islamahmoud97-cpu/Konstruktionsprojekt-/(list of files, cad)

Other CAD files:
OldVersion/60199320_1_20_20.ipt
OldVersion/60199320_2_20.ipt
OldVersion/60199320_3_20.ipt
OldVersion/60199320_4.ipt
OldVersion/Assembly1.iam
OldVersion/Ausgleichskupplung.iam
OldVersion/Compress Spring11.ipt
OldVersion/DIN 59370 - 30 x 3 - 0,001.ipt
OldVersion/DIN1026-1 - U 400 - 1500.ipt
OldVersion/Deckel.ipt
OldVersion/Deckelscheibe.ipt
OldVersion/EN ISO 1127(2) - 10 x 1 - 0,001.ipt
OldVersion/Elektrischer Schalter.ipt
OldVersion/Elektromotor.ipt
OldVersion/Federführungswellen.ipt
OldVersion/Federwellen-Gleitlager.ipt
OldVersion/Festlagertopf.ipt
OldVersion/Führung.ipt
OldVersion/Führungsgleitlager.ipt
OldVersion/Gewindemutter.ipt
OldVersion/Grundplatte.ipt
OldVersion/Gummi platt unten.ipt
OldVersion/Hülle des Plattform-Oberteils.ipt
OldVersion/Hülle des Plattform-Unterteils.ipt
OldVersion/Loslagertopf.ipt
OldVersion/Plattform-Oberteil.ipt
OldVersion/Plattform-Unterteil.ipt
OldVersion/Rubber Kupplung.ipt
OldVersion/Schutzpuffer.ipt
OldVersion/Spindel.ipt
OldVersion/Verbindungsplatte.ipt
OldVersion/Verfahrschlitten.ipt
OldVersion/Wand.ipt
OldVersions/60199320_2_20.0001.ipt
OldVersions/60199320_3_20.0001.ipt
OldVersions/Assembly1.0032.iam
OldVersions/Ausgleichskupplung.0002.iam
OldVersions/Compress Spring11.0001.ipt
OldVersions/DIN 59370 - 30 x 3 - 0,001.0001.ipt
OldVersions/DIN1026-1 - U 400 - 1500.0001.ipt
OldVersions/Deckel oben.0003.ipt
OldVersions/Dekel oben Plattform.0002.ipt
OldVersions/Dekel unten Plattform.0001.ipt
OldVersions/Elektrische Knopf.0001.ipt
OldVersions/Elektromotor.0004.ipt
OldVersions/Federführungswellen.0005.ipt
OldVersions/Festlagertopf.0006.ipt
OldVersions/Festlagertopf.0007.ipt
OldVersions/Führung.0001.ipt
OldVersions/Gewinde Mutter Mitte.0001.ipt
OldVersions/Gewindemutter.0002.ipt
OldVersions/Gewindemutter.0003.ipt
OldVersions/Gleit lager führung.0001.ipt
OldVersions/Gleit lager führung.0002.ipt
OldVersions/Gleit überlast.0002.ipt
OldVersions/Grundgestell.0004.ipt
OldVersions/Grundplatte.0005.ipt
OldVersions/Grundplatte.0006.ipt
OldVersions/Gummi platt unten.0001.ipt
OldVersions/Loslagertopf.0005.ipt
OldVersions/Oben.0004.ipt
OldVersions/Oben.0005.ipt
OldVersions/Platt oben.0004.ipt
OldVersions/Platt unten.0004.ipt
OldVersions/Plattform-Oberteil.0006.ipt
OldVersions/Plattform-Unterteil.0006.ipt
OldVersions/Spindel.0010.ipt
OldVersions/Unten.0004.ipt
OldVersions/Verfahrschlitten.0006.ipt
OldVersions/Wand.0003.ipt
OldVersions/gummi Muttergewinde.0003.ipt
OldVersions/mitte.0005.ipt
OldVersions/saule.0004.ipt
OldVersions/Überlast Führung.0002.ipt
OldVersions/Überlast Führung.0003.ipt
