islamahmoud97-cpu/Konstruktionsprojekt-/12_SaadMahmoud Islam_Z.pdf

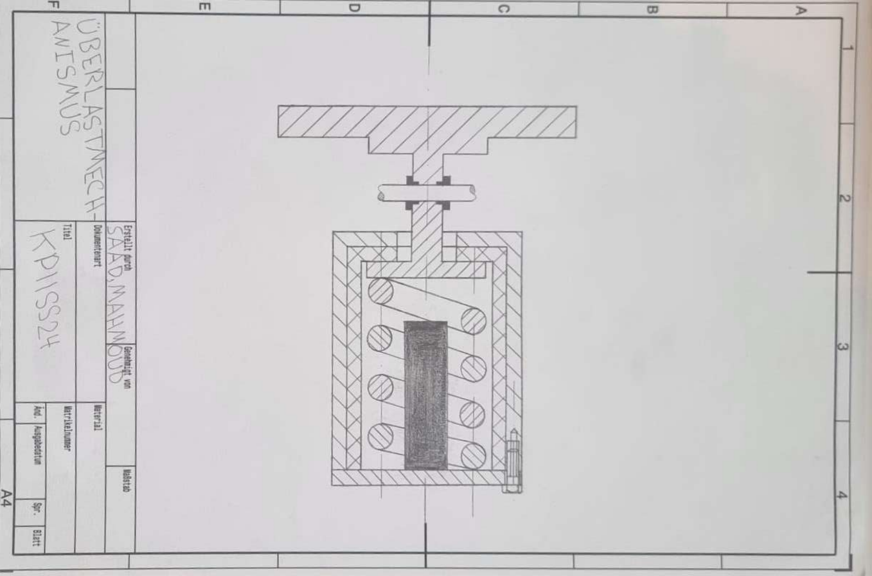
[picture p10: page 1]
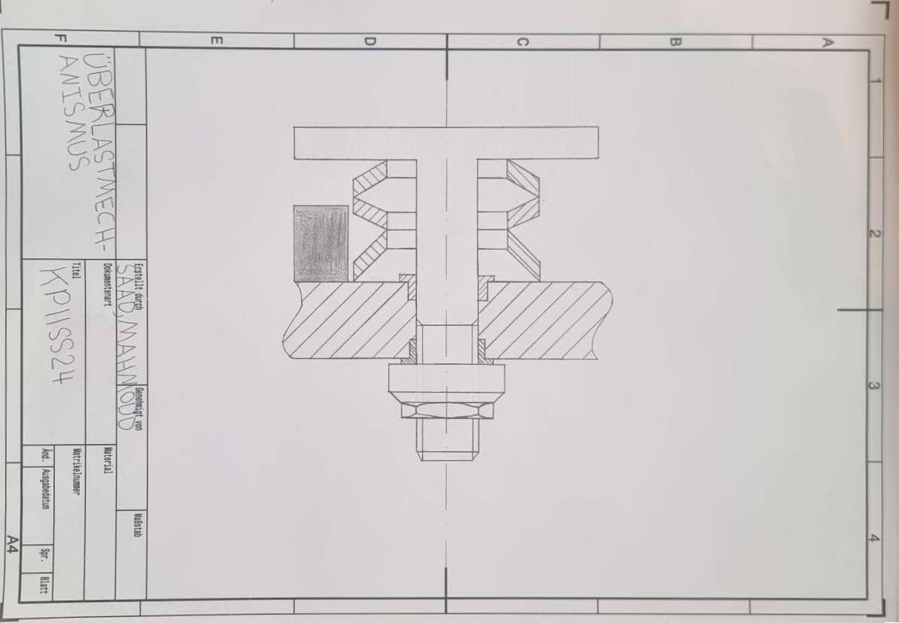
[picture p11: page 2]
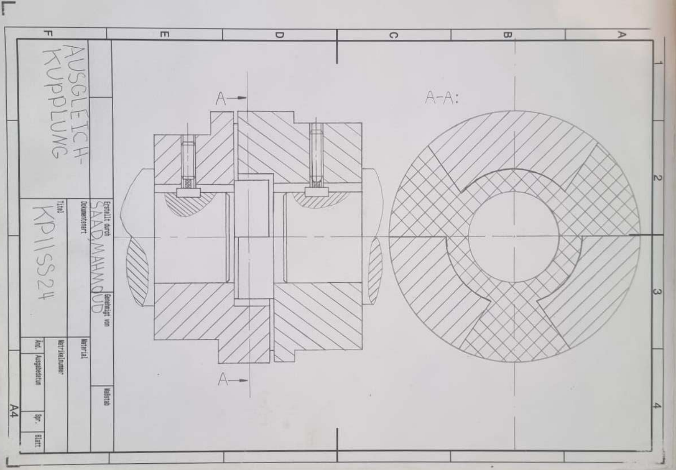
[picture p12: page 3]
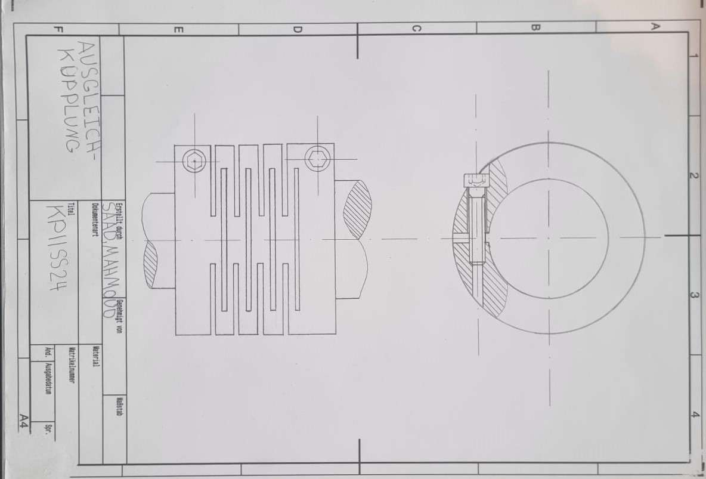
[picture p13: page 4]
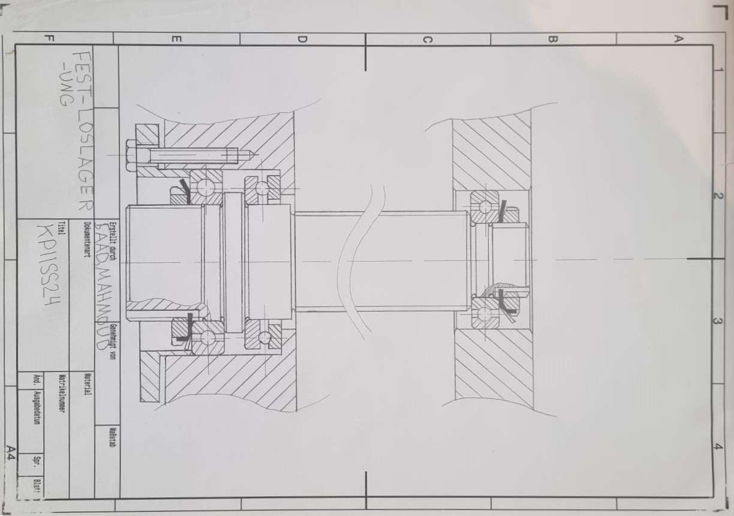
[picture p14: page 5]
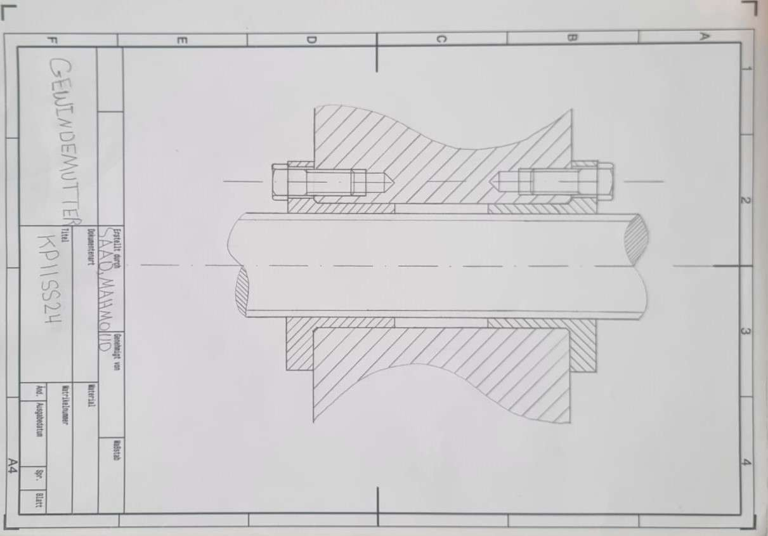
[picture p15: page 6]
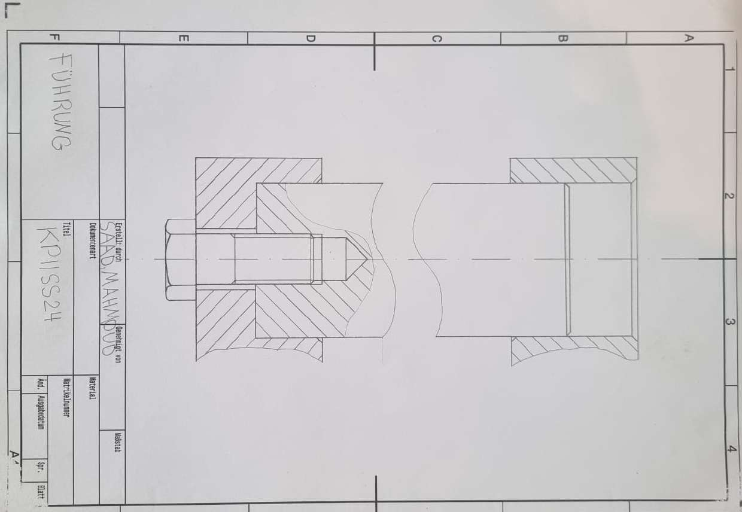
[picture p16: page 7]
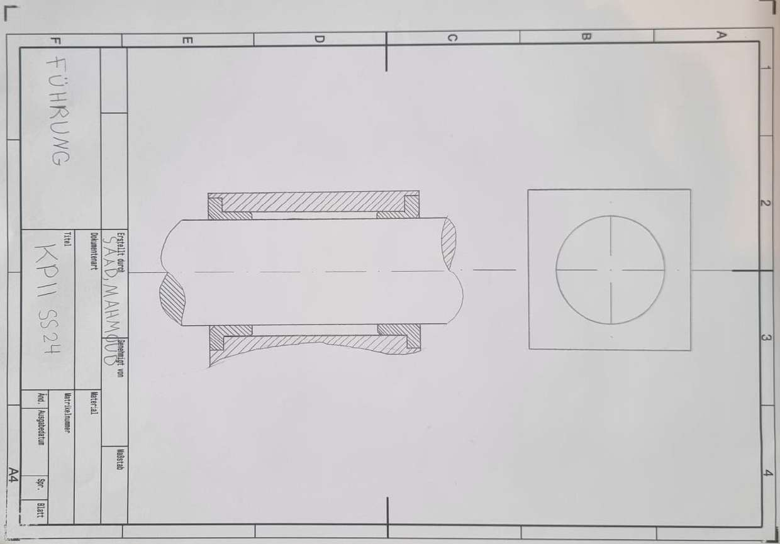
[picture p17: page 8]
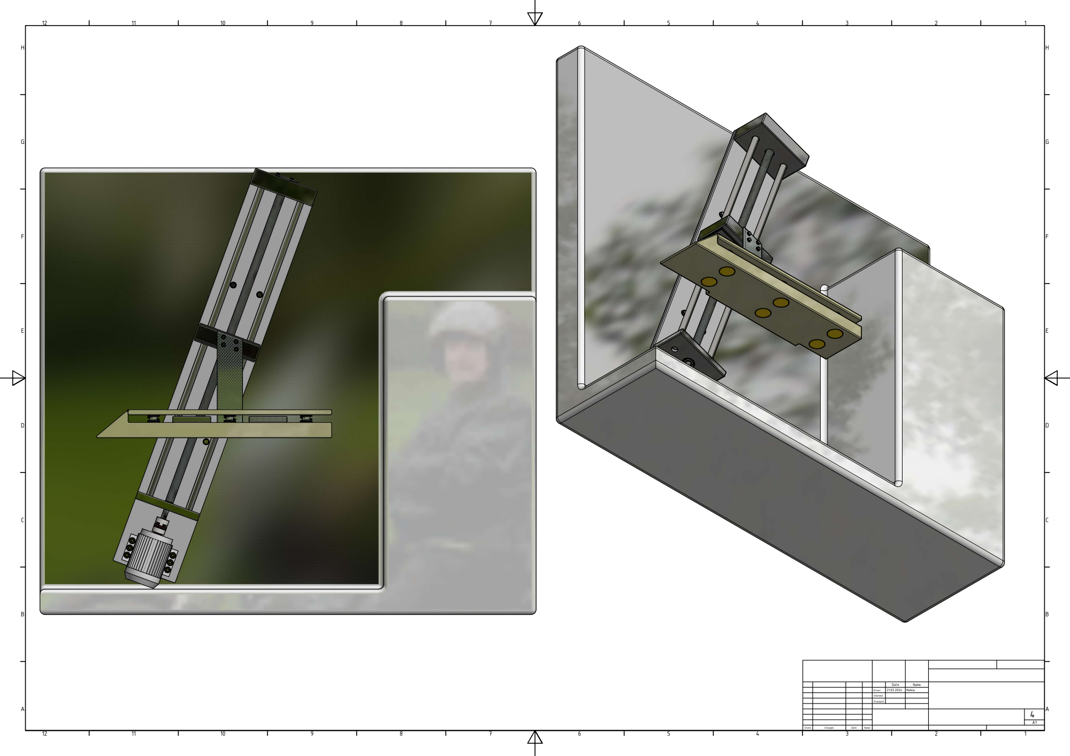
[picture p18: page 9]

D r a w n | 1.0 3.2 | N o kia

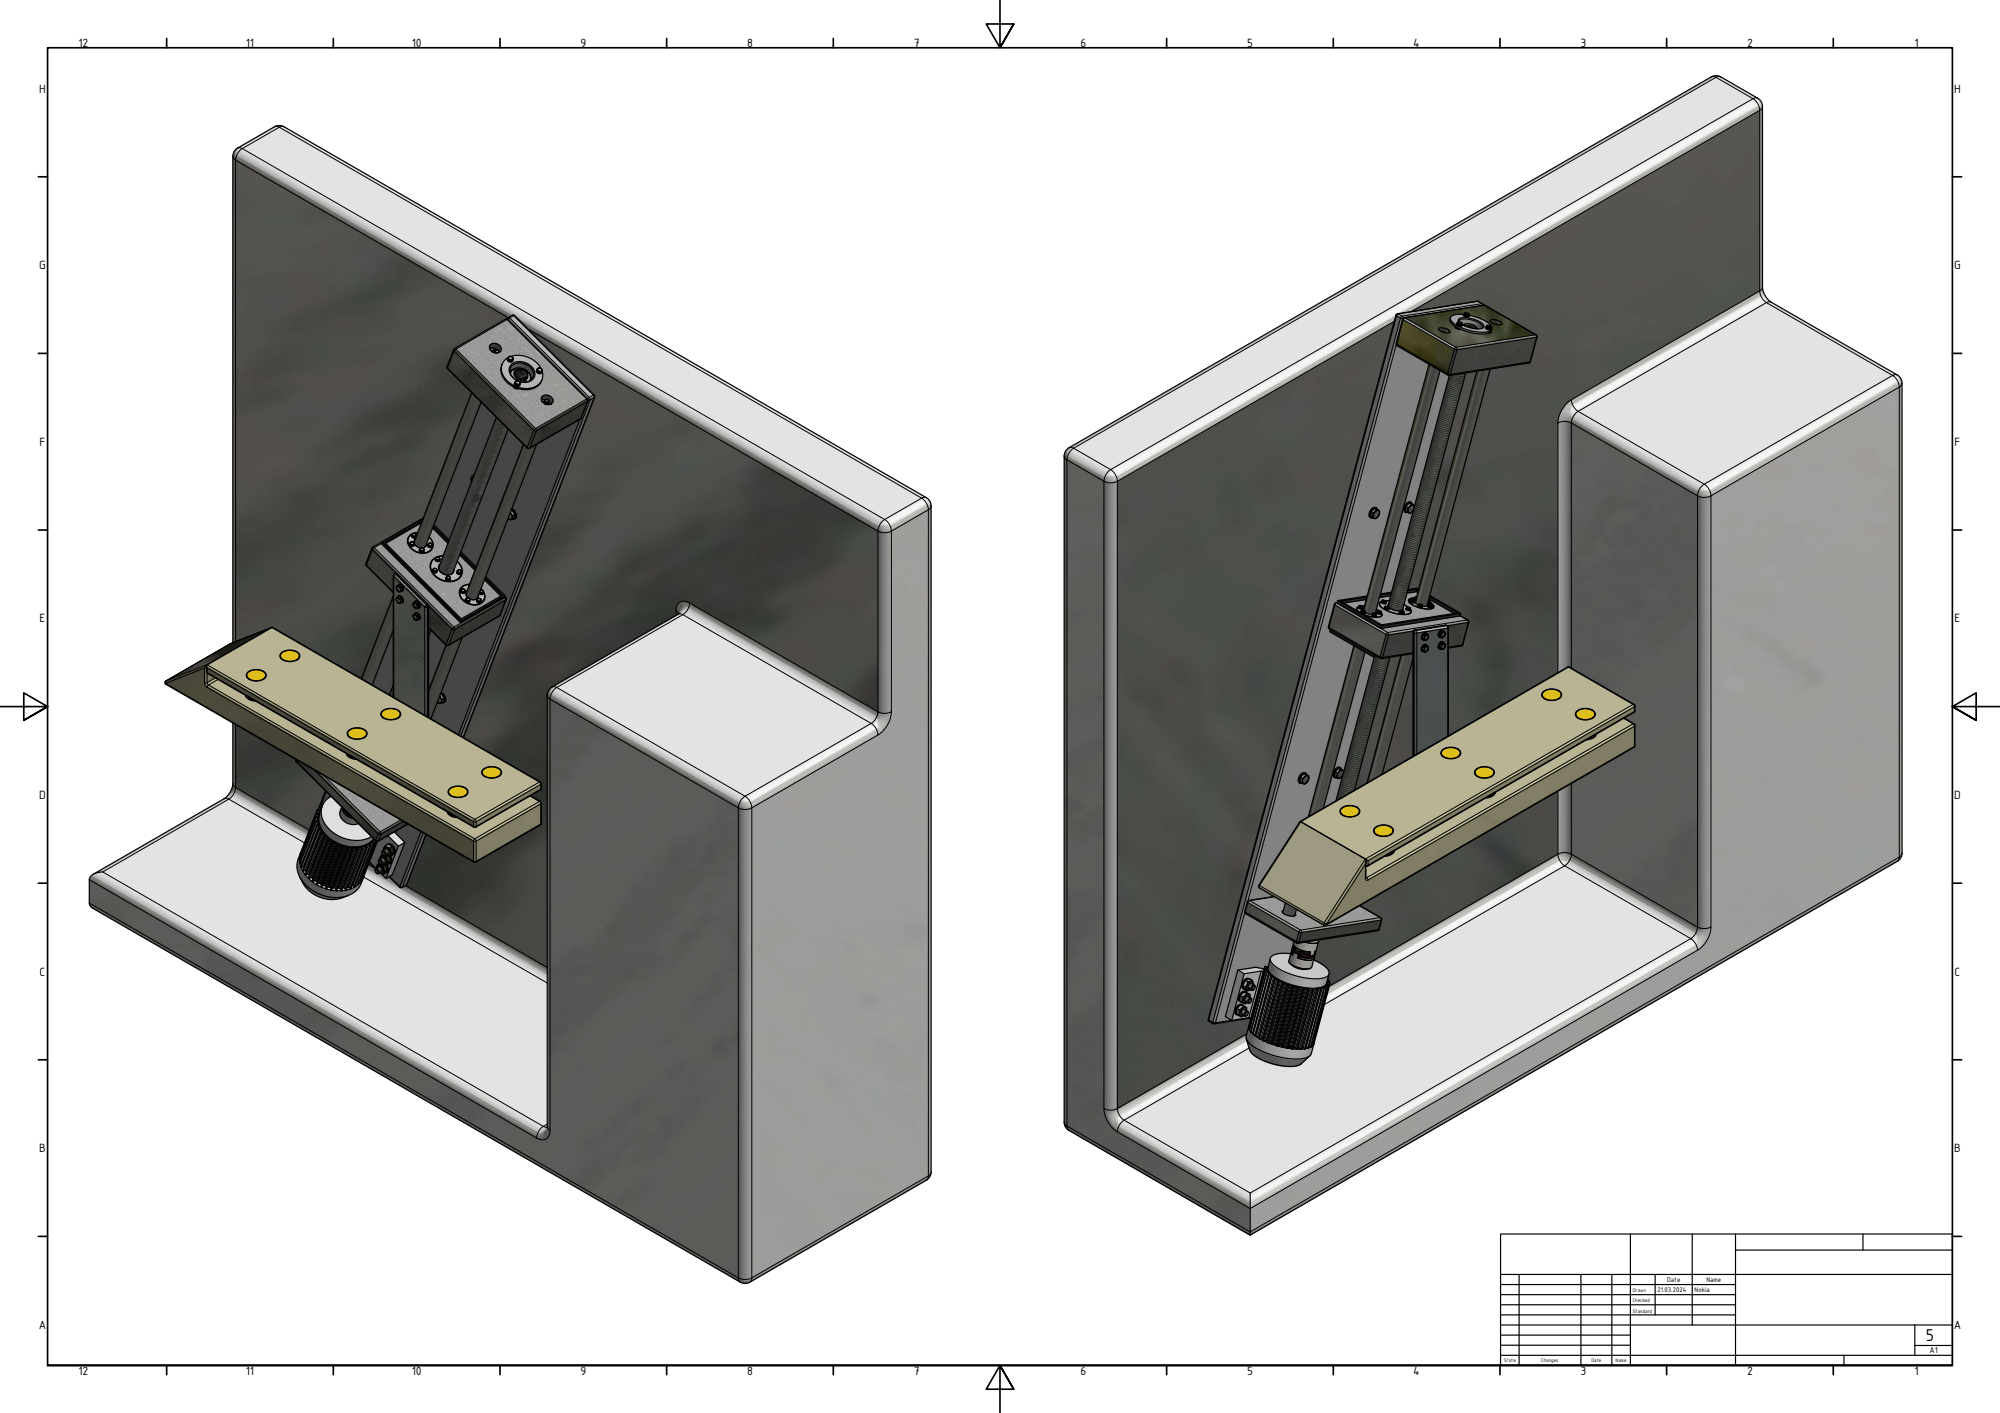
[picture p19: page 10]

D r a w n | 1.0 3.2 | N o kia

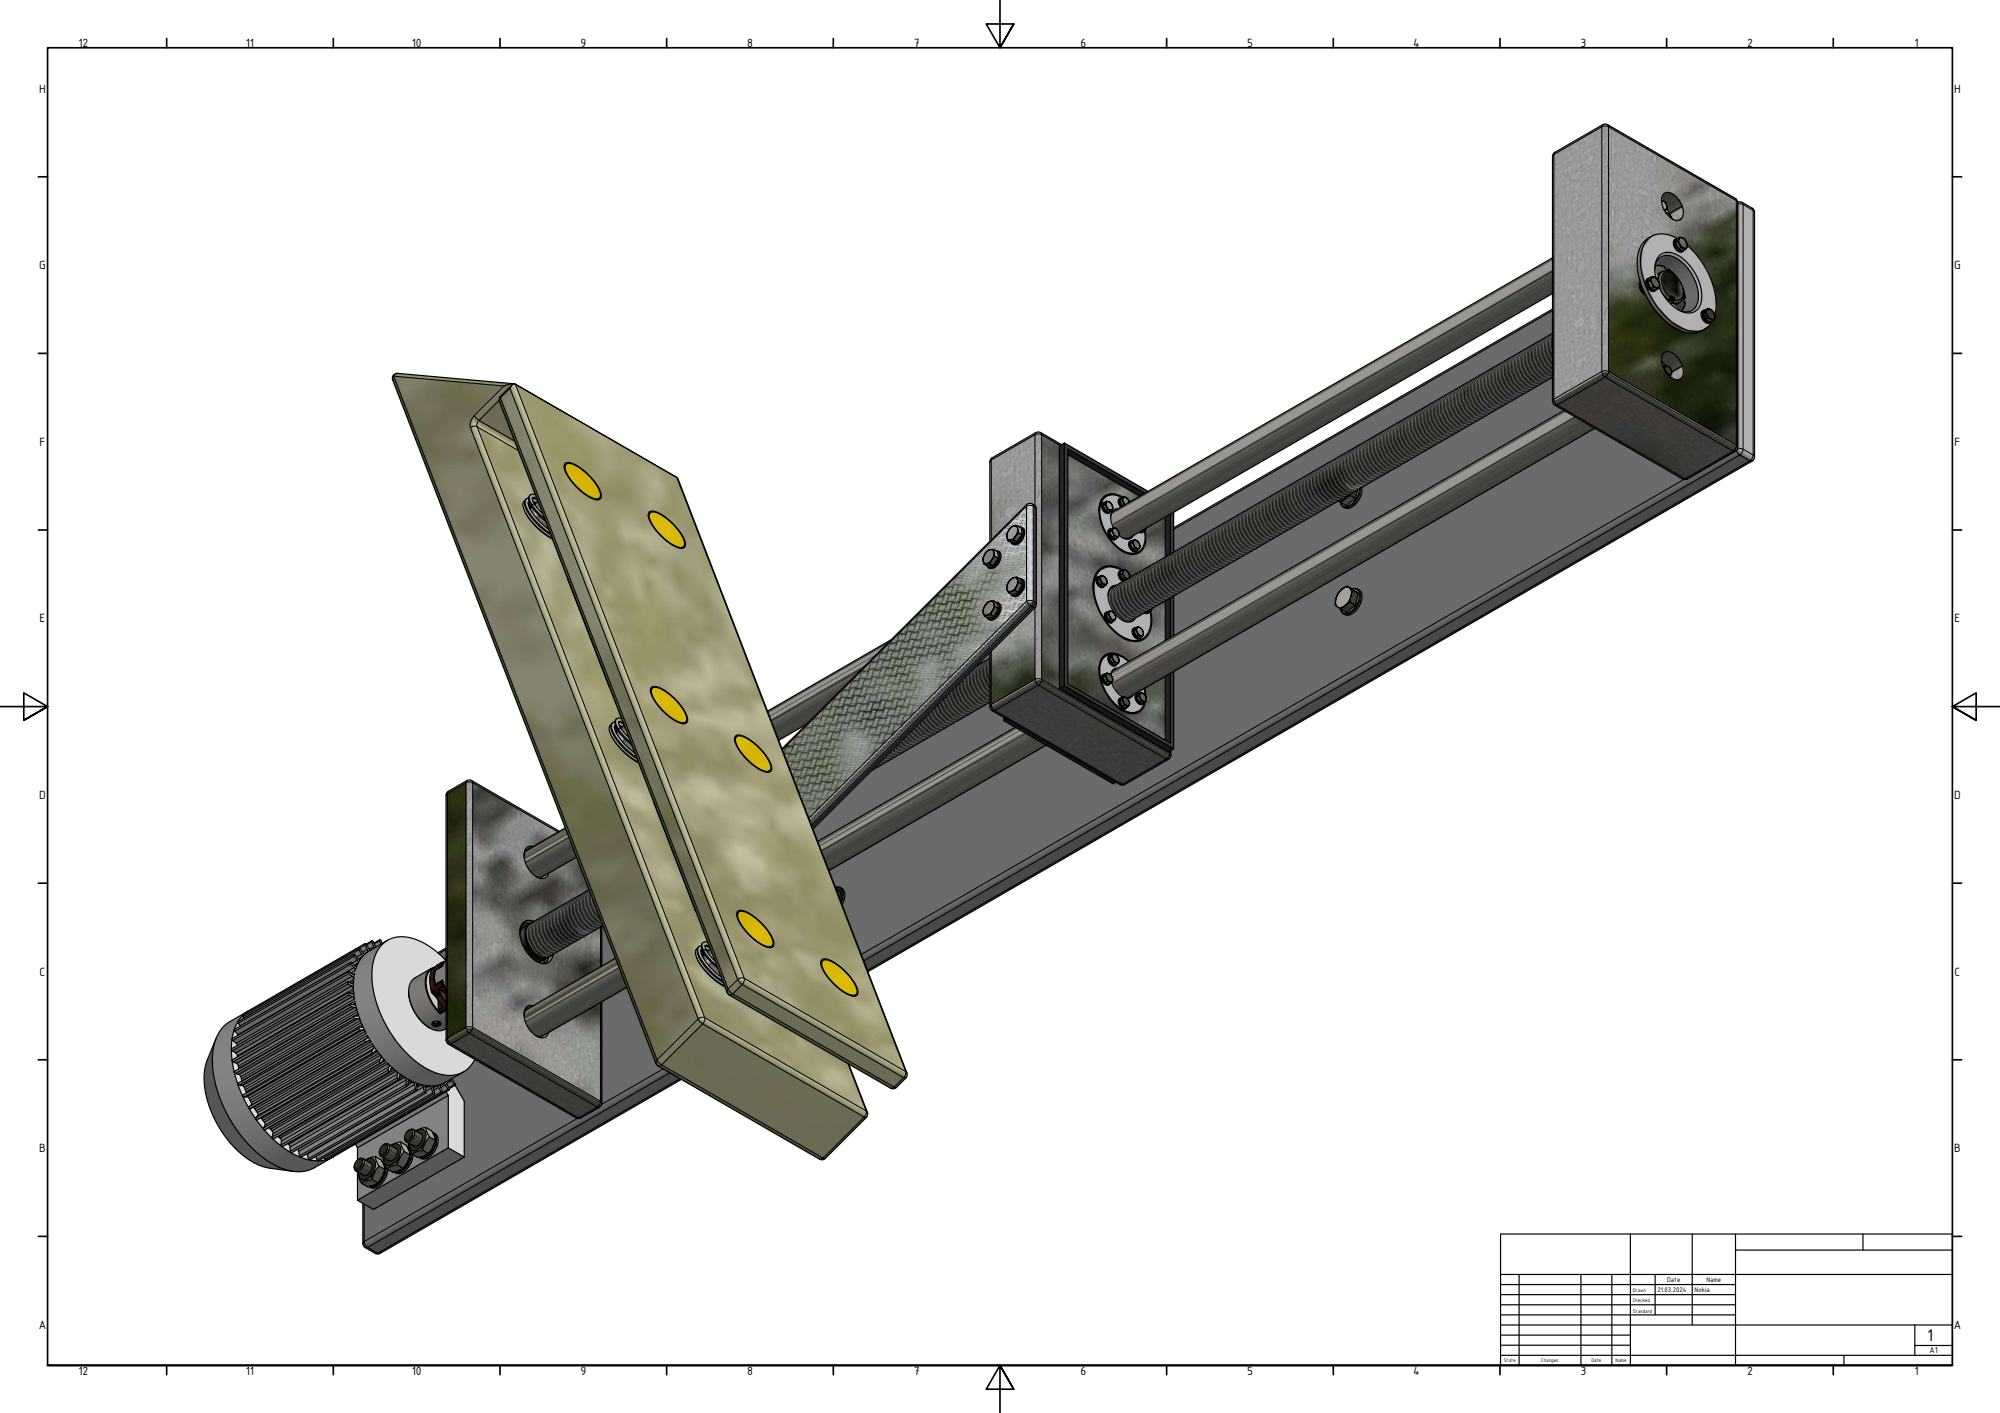
[picture p20: page 11]

D r a w n | 1.0 3.2 | N o kia

A ( 1 : 2,2 )

C | C

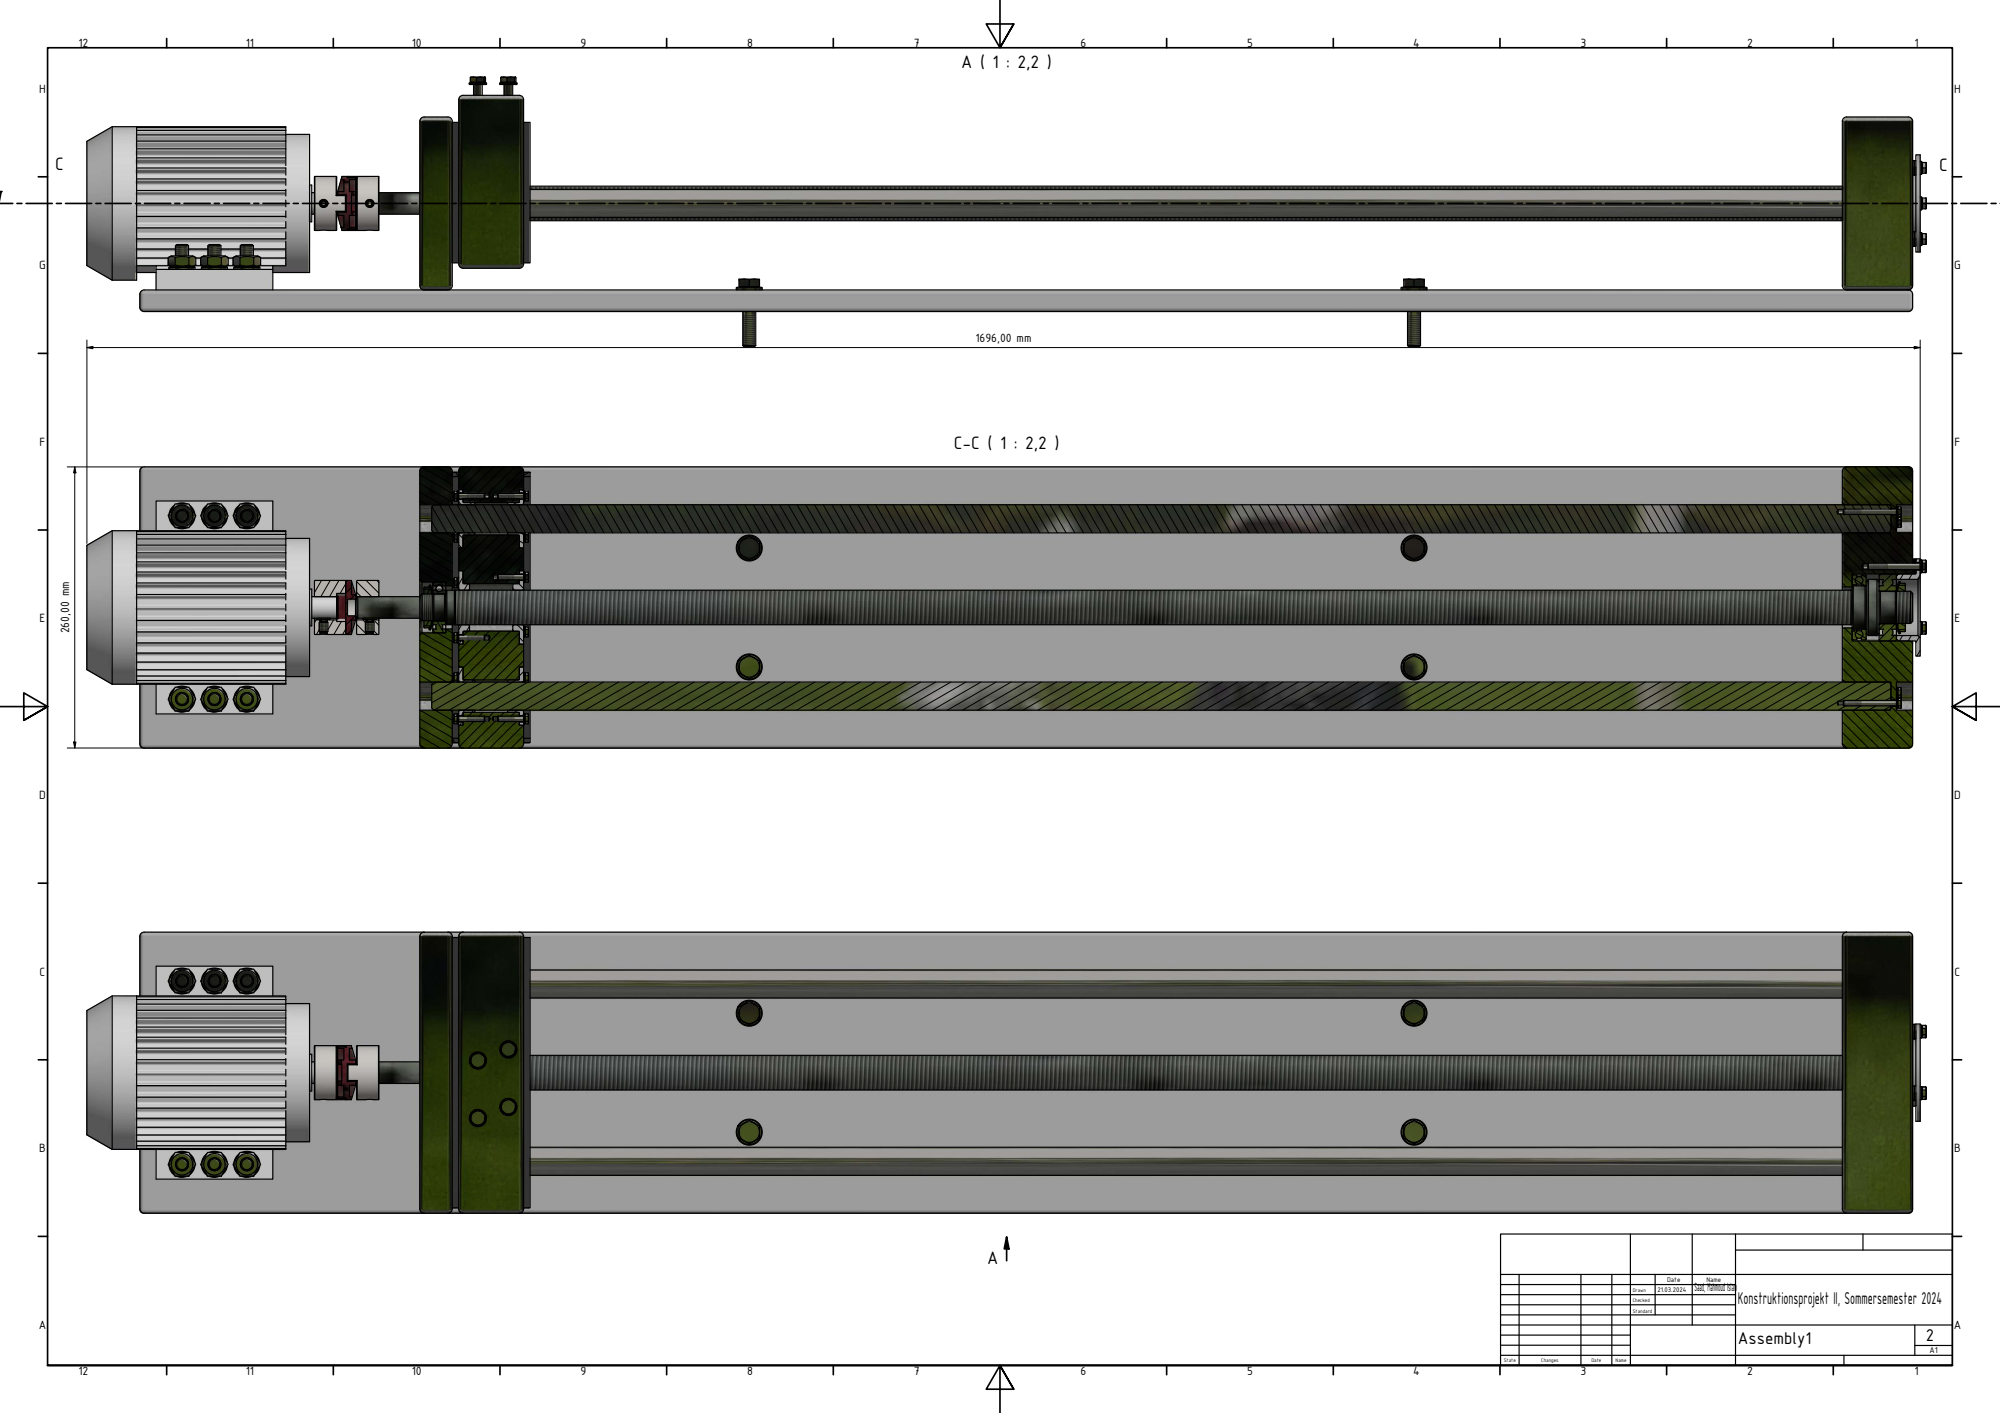
[picture p21: page 12]
Assembly1; State; Changes; Date; Name

Date | Name | Konstruktionsprojekt II, Sommersemester 2024

Drawn | 21.03.2024 | Saad, Mahmoud Islam

Checked

Standard

E ( 1 : 2 )

E

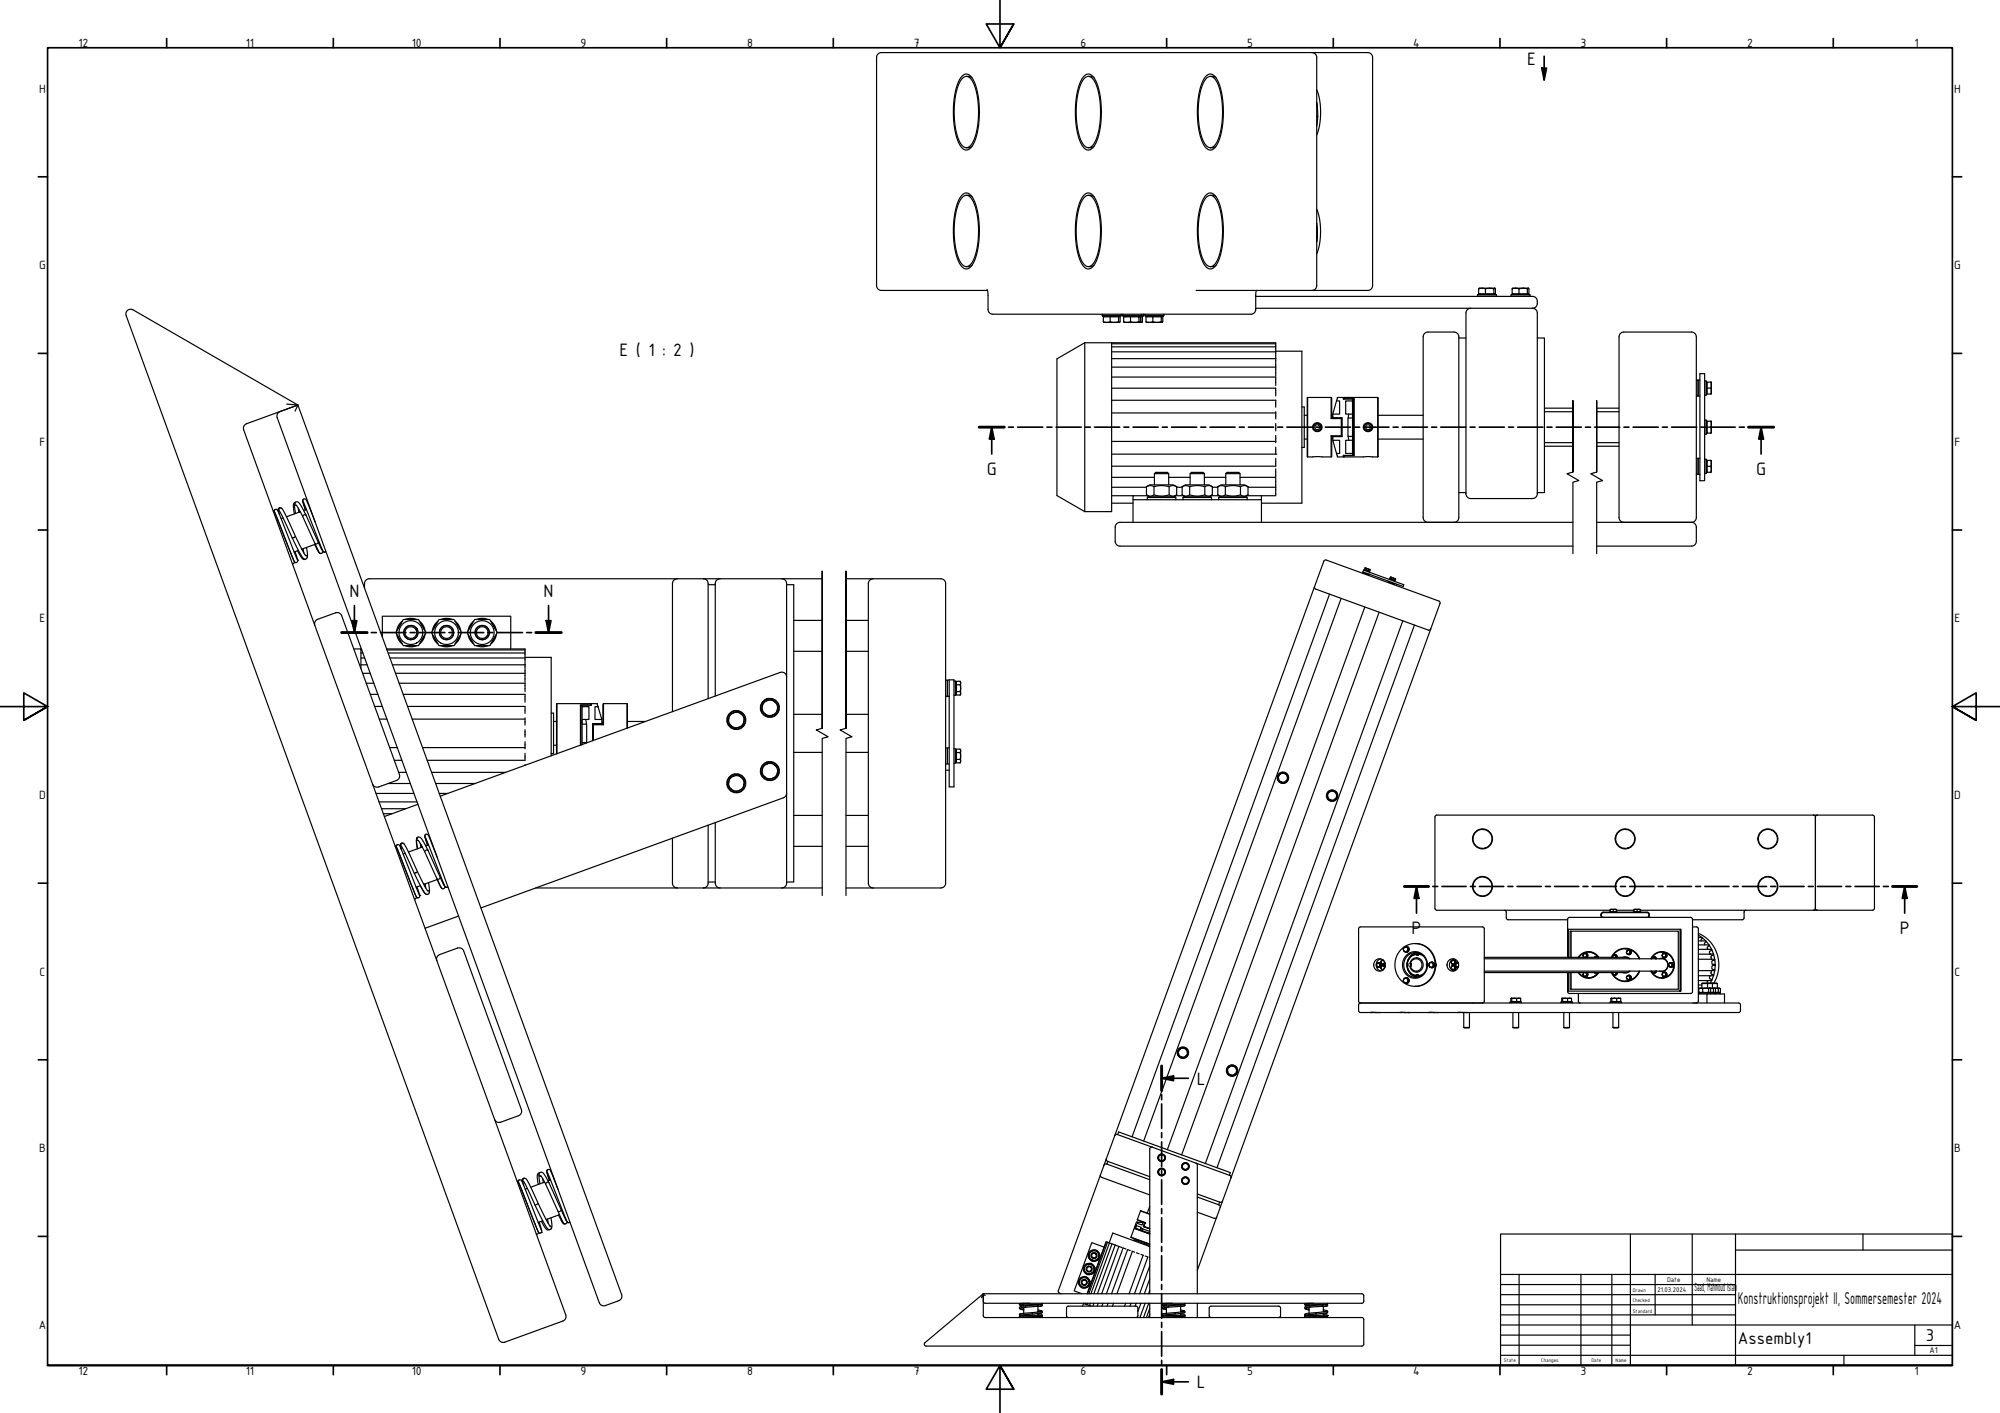
[picture p22: page 13]
Assembly1; State; Changes; Date; Name

Date | Name | Konstruktionsprojekt II, Sommersemester 2024

Drawn | 21.03.2024 | Saad, Mahmoud Islam

Checked

Standard

G-G ( 1 : 1 )

R-R ( 2 : 1 )

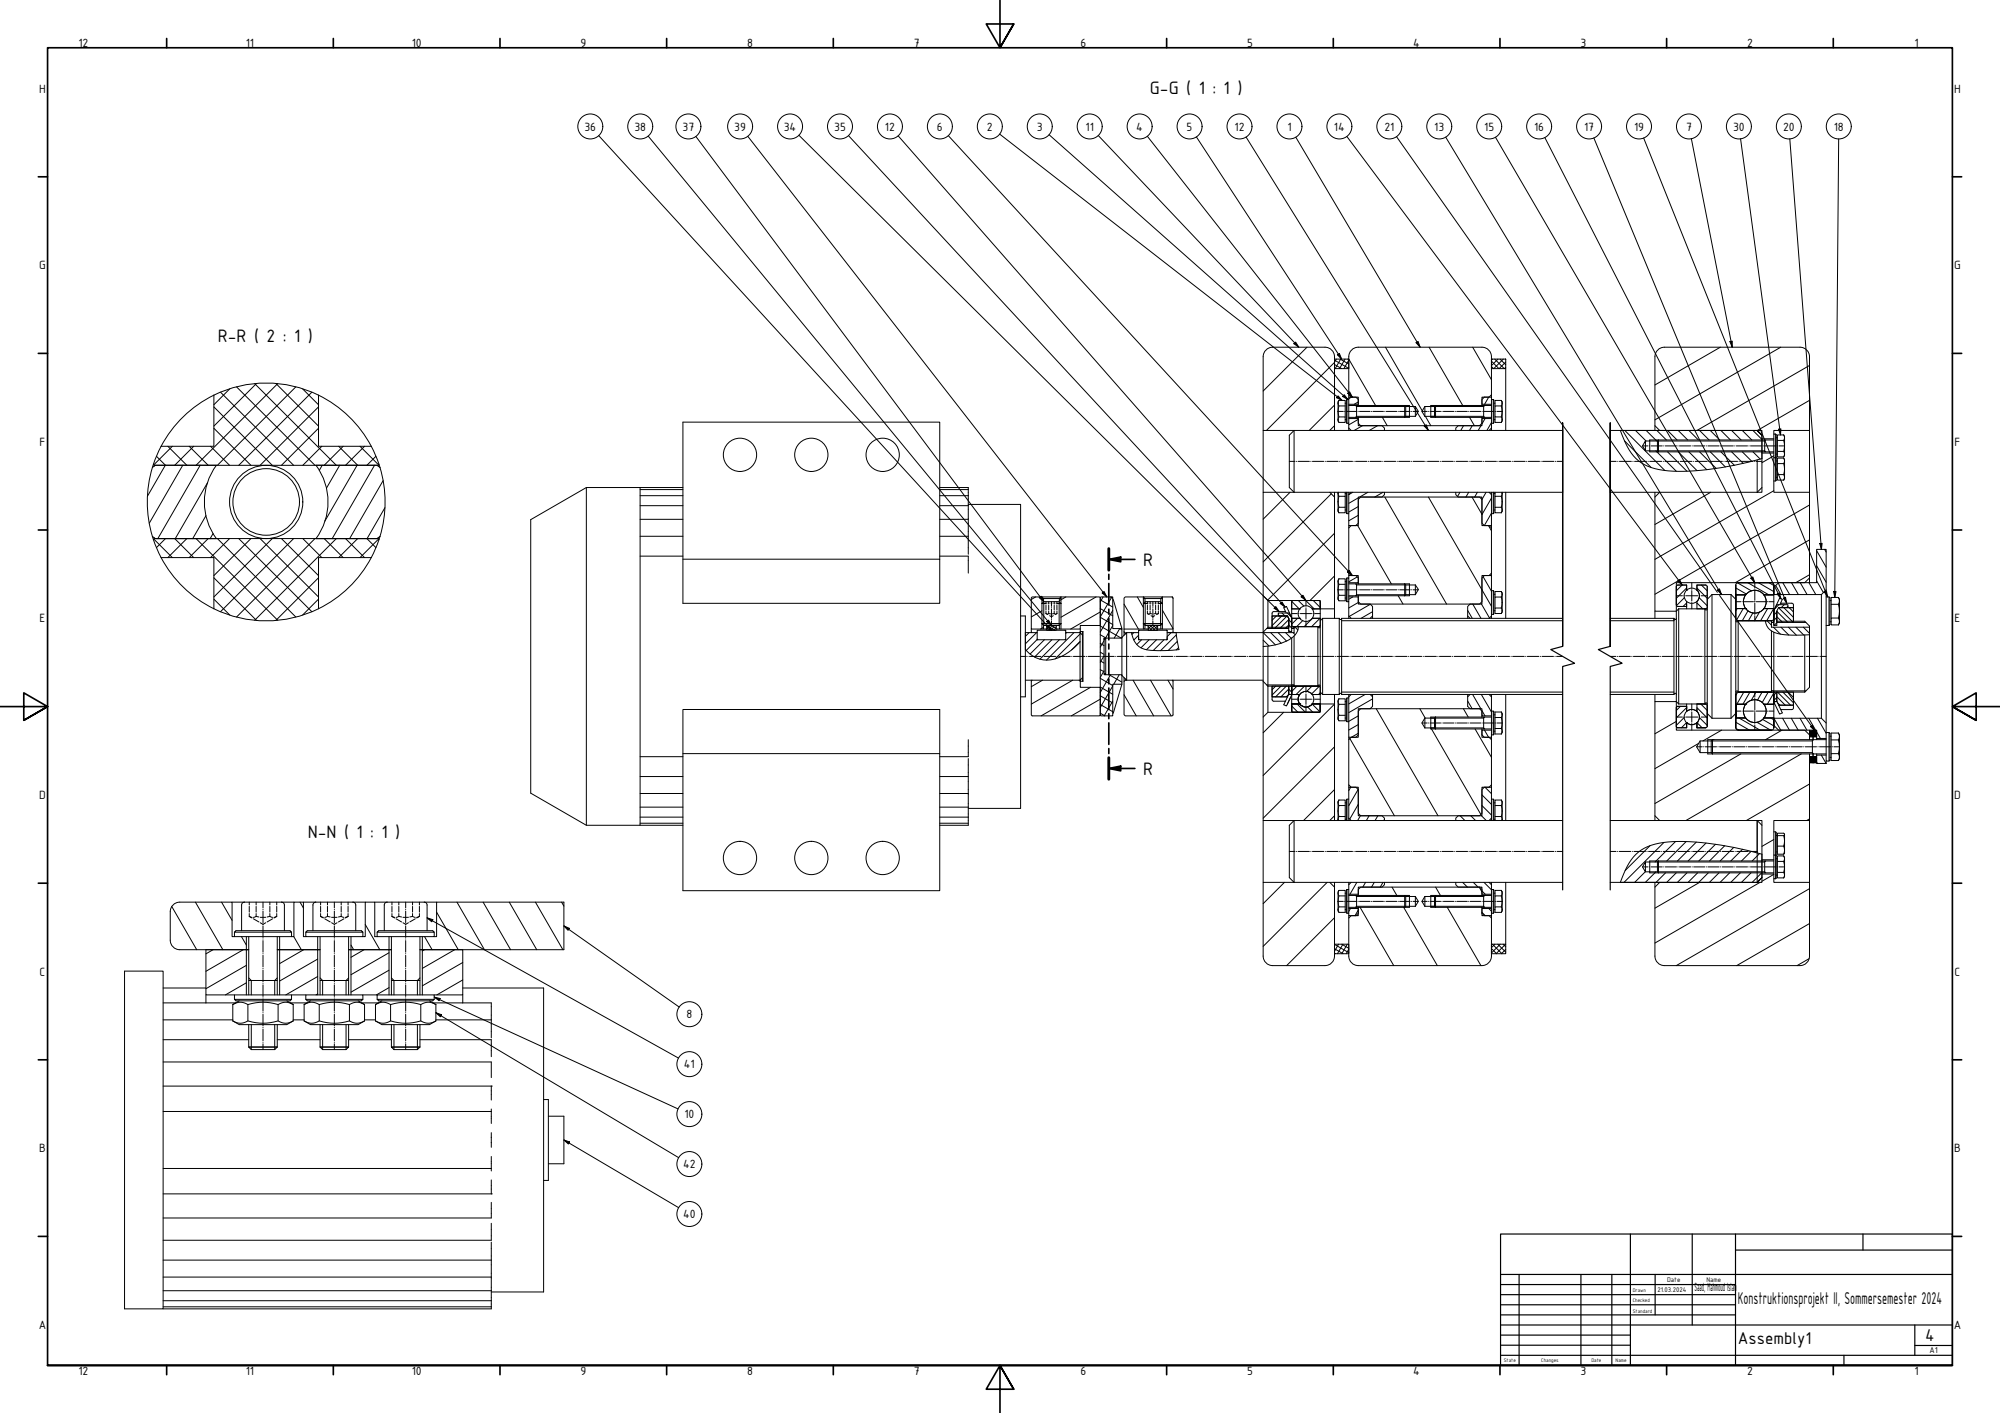
[picture p23: page 14]
Assembly1; State; Changes; Date; Name

Date | Name | Konstruktionsprojekt II, Sommersemester 2024

Drawn | 21.03.2024 | Saad, Mahmoud Islam

Checked

Standard

L-L ( 1 : 1 )

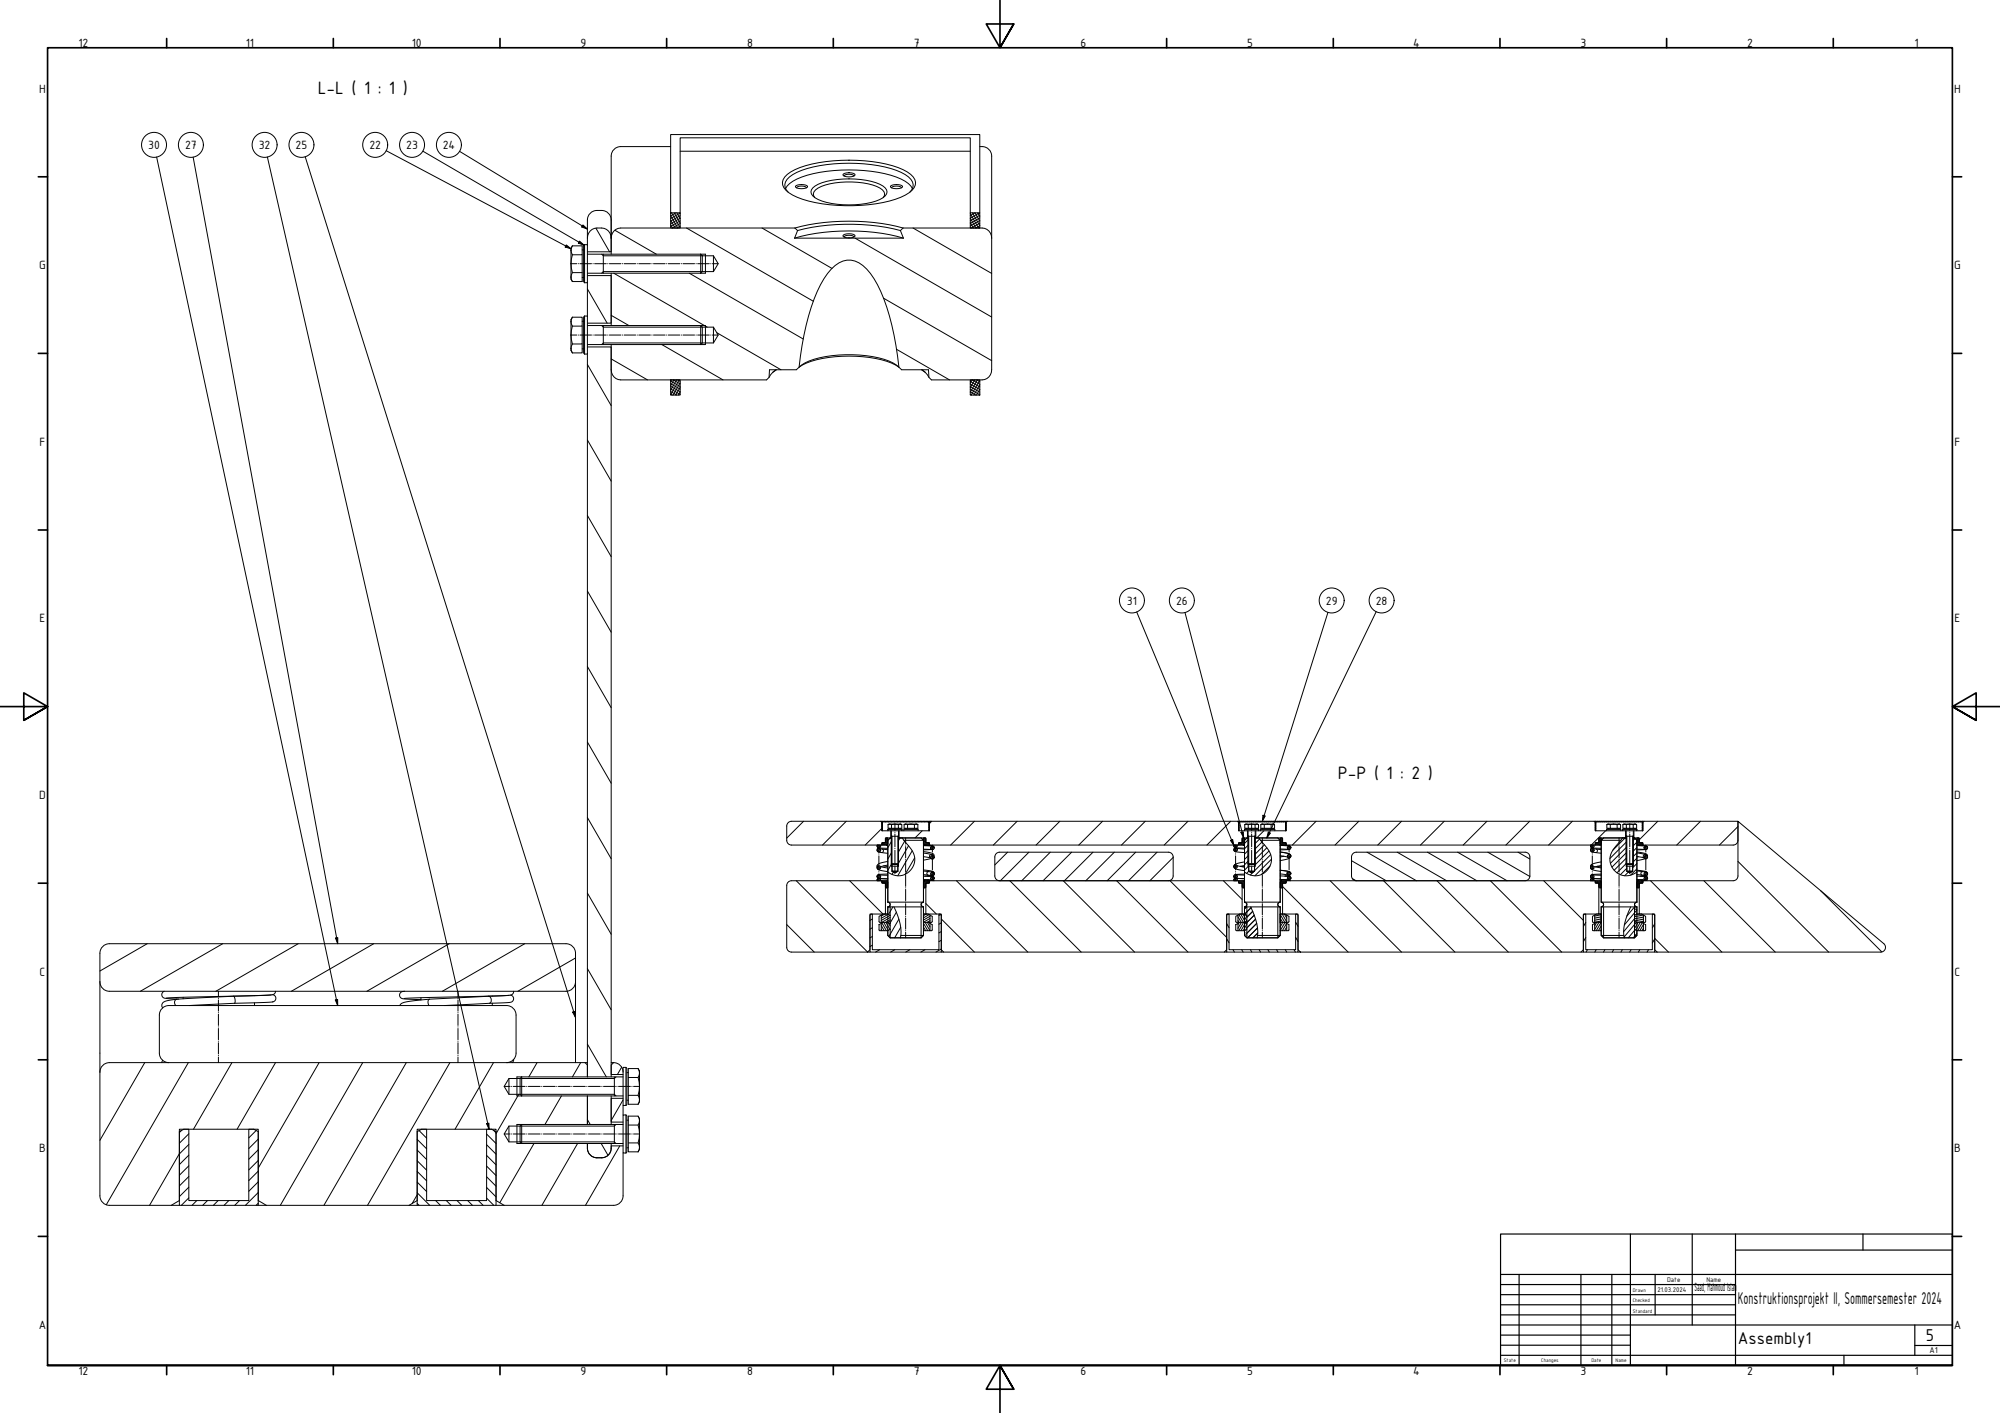
[picture p24: page 15]
Assembly1; State; Changes; Date; Name

Date | Name | Konstruktionsprojekt II, Sommersemester 2024

Drawn | 21.03.2024 | Saad, Mahmoud Islam

Checked

Standard

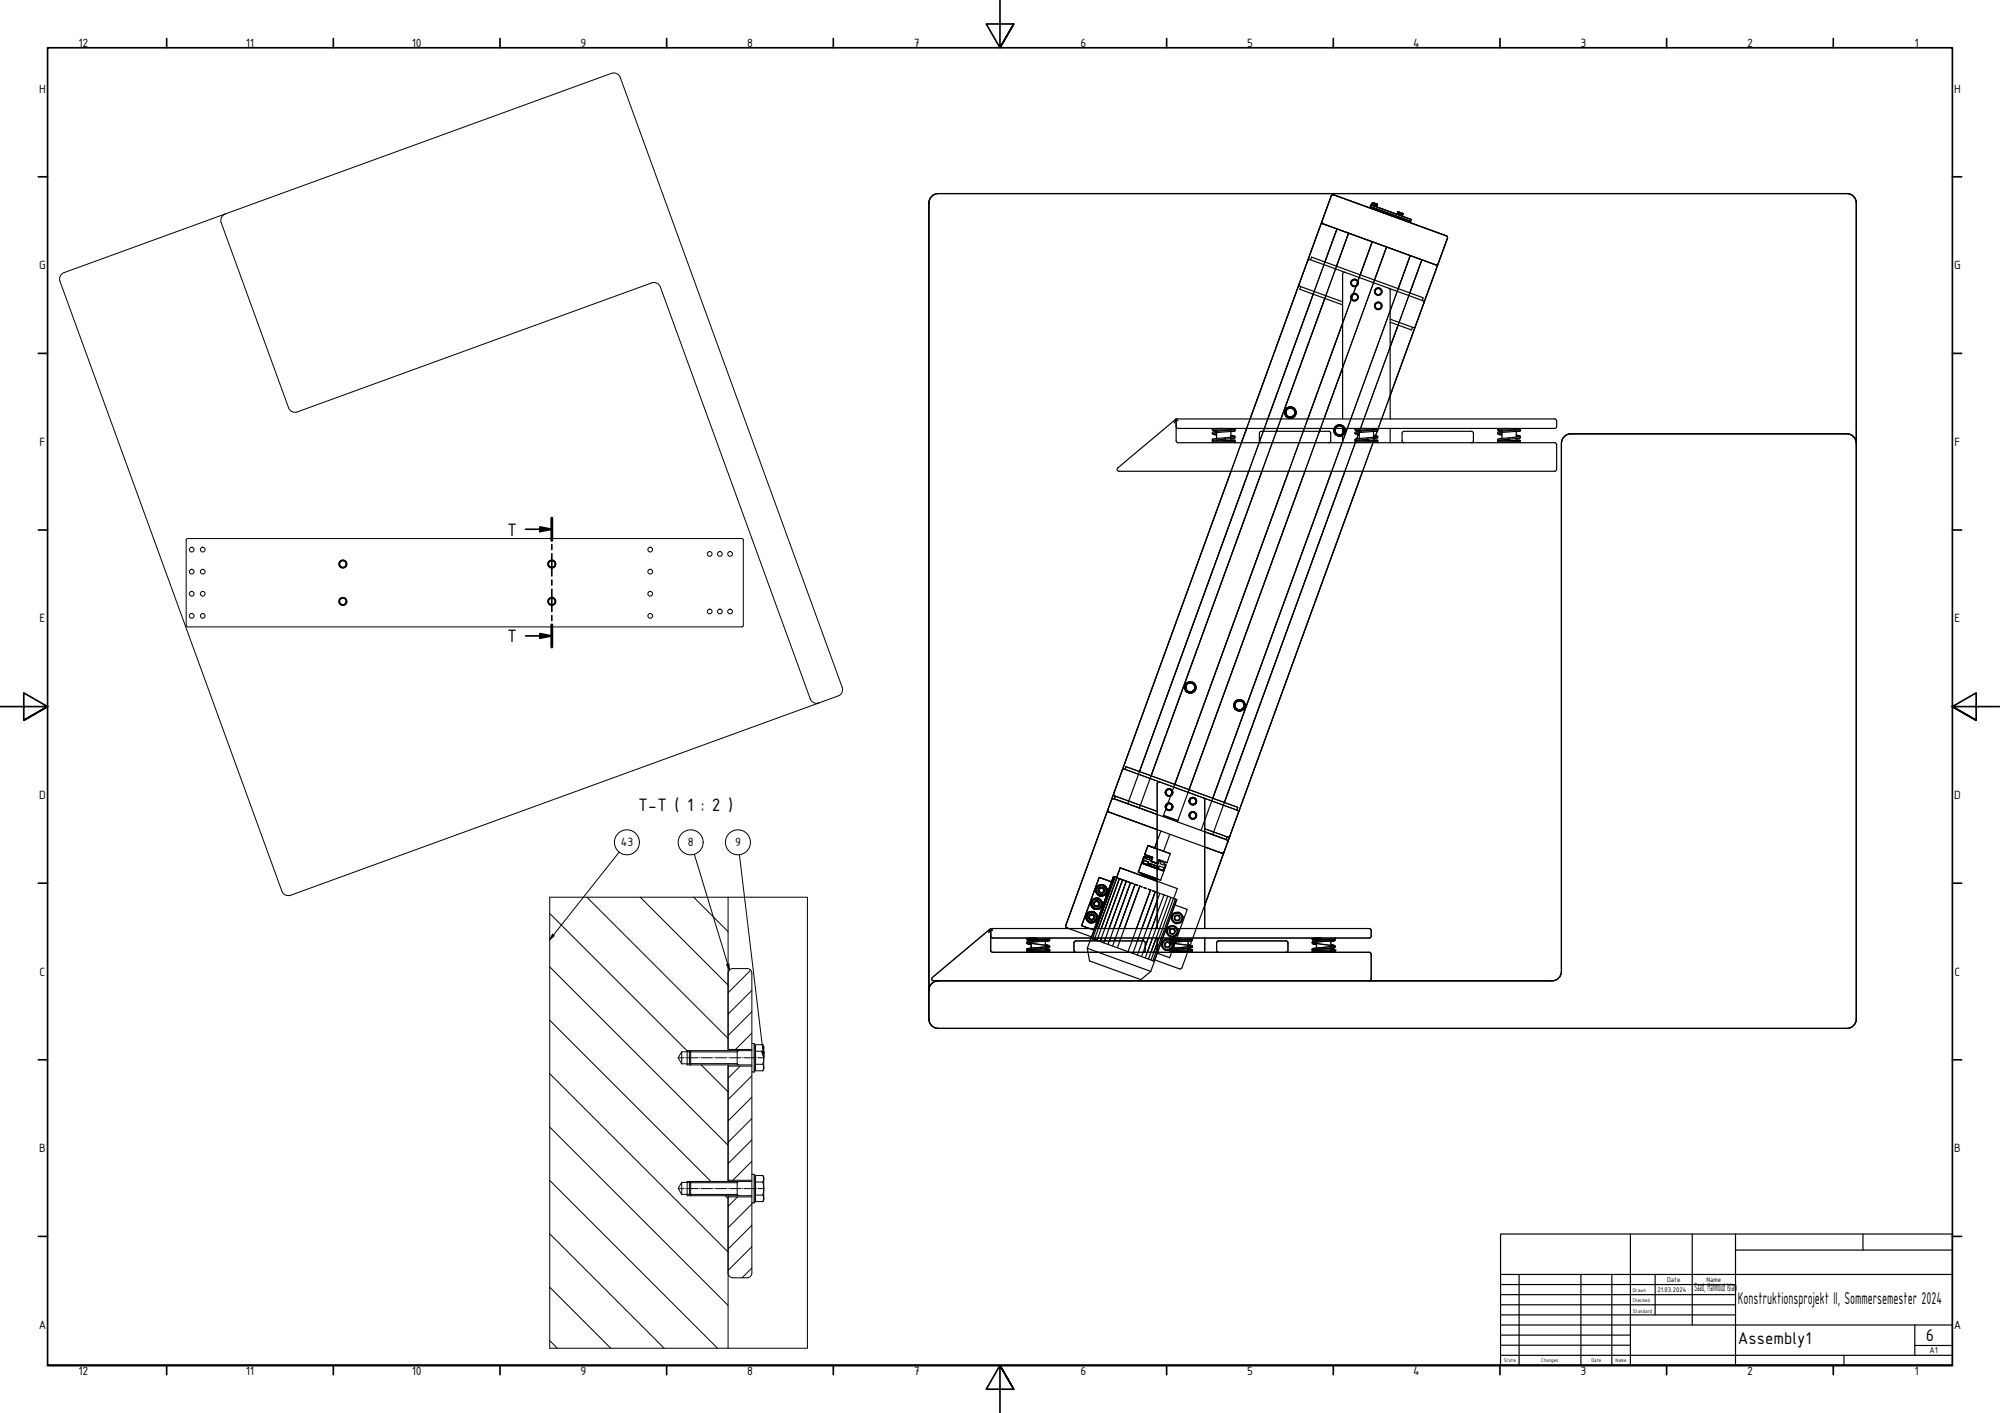
[picture p25: page 16]
Assembly1; State; Changes; Date; Name

Date | Name | Konstruktionsprojekt II, Sommersemester 2024

Drawn | 21.03.2024 | Saad, Mahmoud Islam

Checked

Standard
